znoxx/ARCAdaptor/README.md

ARCAdaptor
==========
https://github.com/znoxx/ARCAdaptor

Arcadaptor stuff - schematic, firmware, libs

For details, check http://adaptor.su
=======
