znoxx/ARCAdaptor/hardware/readme.txt

In EAGLECAD format. No board still, but quite easy to make your own or buy pre-made at http://adapto.rs
