znoxx/ARCAdaptor/projects/ARCAdaptor_USBasp/README.md

This project intended to adapt original USBasp programmer code with ARCAdaptor
Original file from http://www.fischl.de/usbasp/ for preservation
Directory "replacement" contains patched files - to compile - replace original content with them.
Pins of ARCAdaptor used:

X2-13 PB2 - Reset
X2-15 PB3 - MOSI
X1-3 PB4 - MISO
X1-1 PB5 - SCK

Also possible to attach leds to pins
X1-5 PC0 LED1
X1-7 PC1 LED2
Anyway, check pin assignemt according to original USBasp schematics + ARCAdaptor pin assignment - http://adapto.rs/arc/doc/
