znoxx/ARCAdaptor/docs/wikiimages/1-bascom-avr-start.jpg

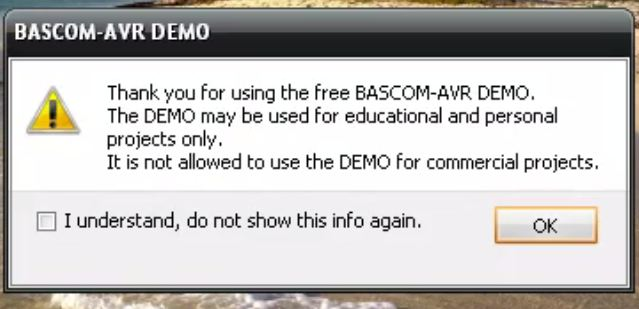
docs/wikiimages/1-bascom-avr-start.jpg
