znoxx/ARCAdaptor/docs/wikiimages/2-bascom-avr-load.jpg

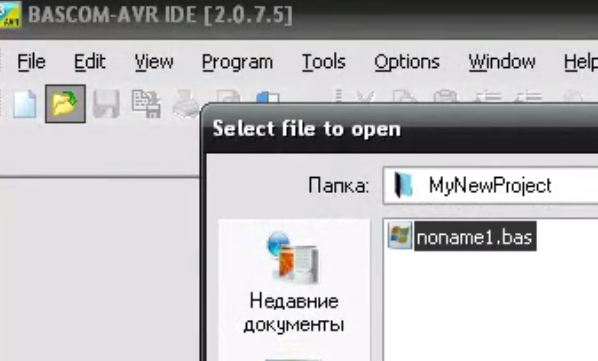
docs/wikiimages/2-bascom-avr-load.jpg
