znoxx/ARCAdaptor/docs/wikiimages/2buttonjoy-diagramm.png

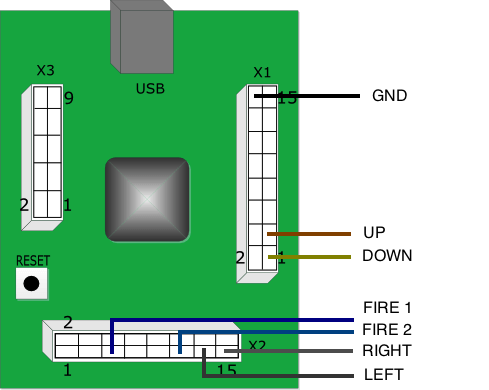
docs/wikiimages/2buttonjoy-diagramm.png
