znoxx/ARCAdaptor/docs/wikiimages/2buttonjoy-photo.jpg

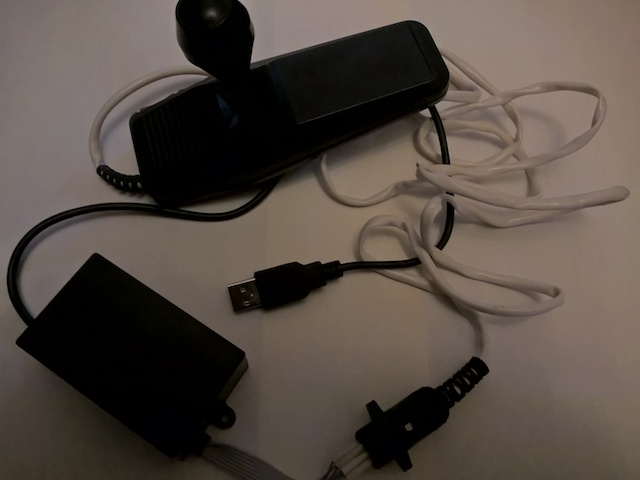
docs/wikiimages/2buttonjoy-photo.jpg
