znoxx/ARCAdaptor/docs/wikiimages/2buttonjoy-screenshot.png

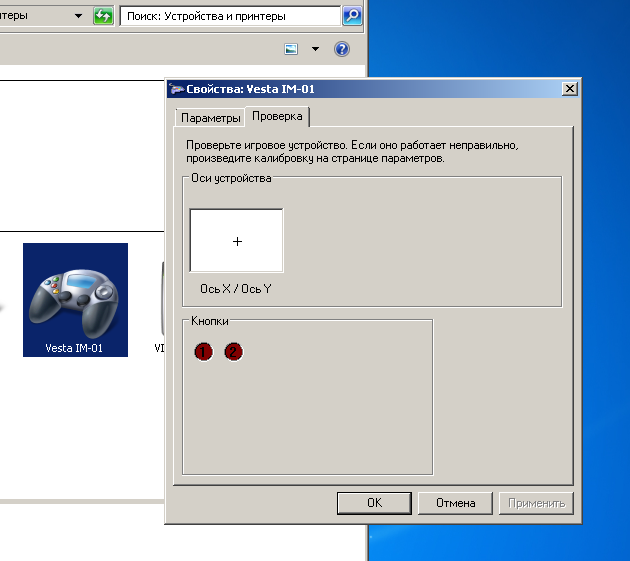
docs/wikiimages/2buttonjoy-screenshot.png
