znoxx/ARCAdaptor/docs/wikiimages/3-loaded-file.jpg

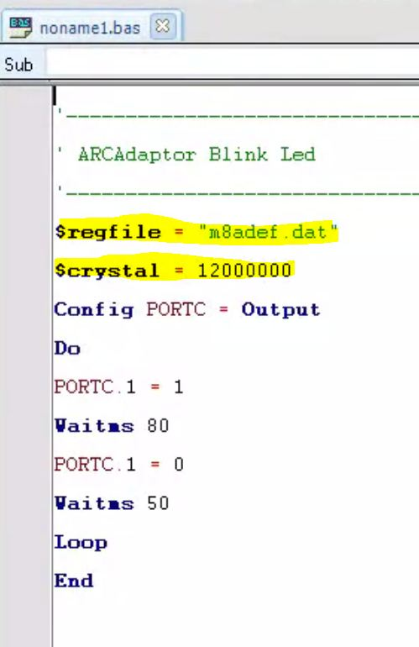
docs/wikiimages/3-loaded-file.jpg
