znoxx/ARCAdaptor/docs/wikiimages/4-chipmenuselect.jpg

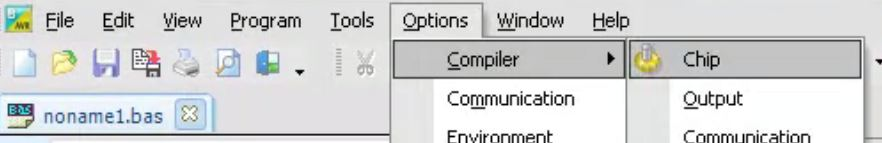
docs/wikiimages/4-chipmenuselect.jpg
