znoxx/ARCAdaptor/docs/wikiimages/5-programmer-options.jpg

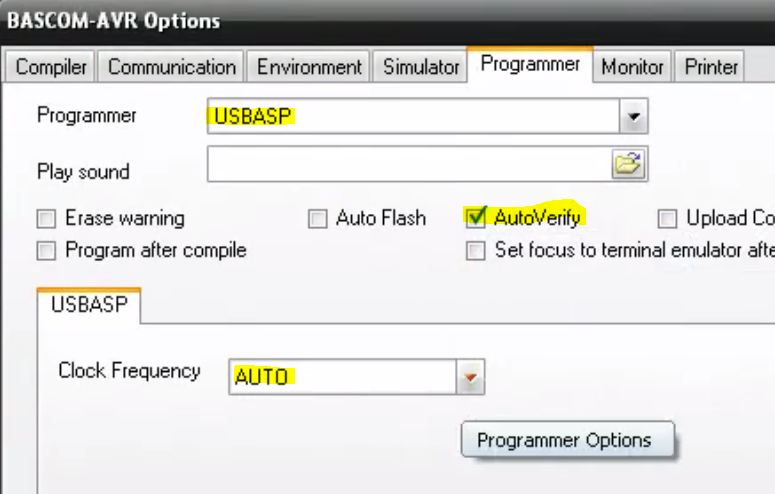
docs/wikiimages/5-programmer-options.jpg
