znoxx/ARCAdaptor/docs/wikiimages/6-atmega8aselection.jpg

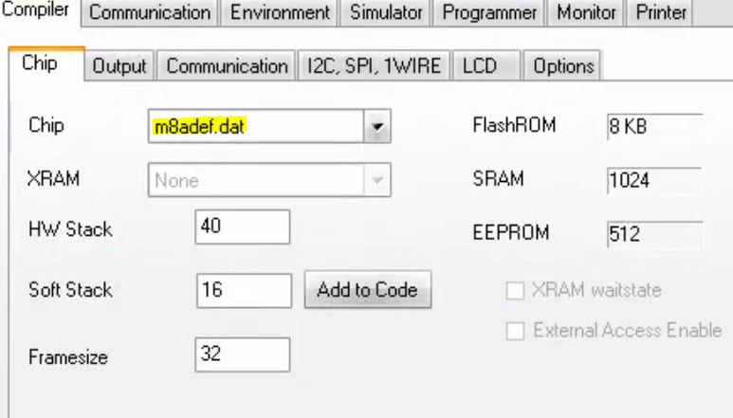
docs/wikiimages/6-atmega8aselection.jpg
