znoxx/ARCAdaptor/docs/wikiimages/7-select-frequency.jpg

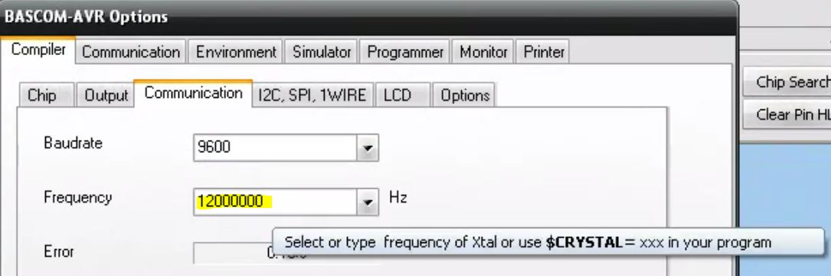
docs/wikiimages/7-select-frequency.jpg
