znoxx/ARCAdaptor/docs/wikiimages/8-add_to_code_optional.jpg

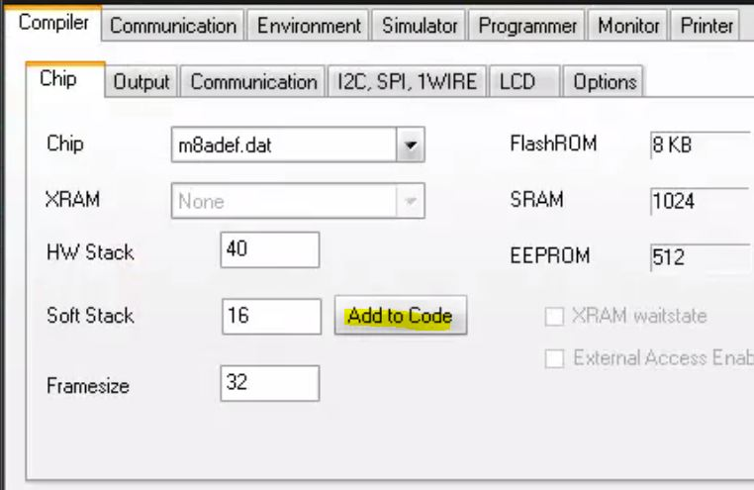
docs/wikiimages/8-add_to_code_optional.jpg
