znoxx/ARCAdaptor/docs/wikiimages/9-compile.jpg

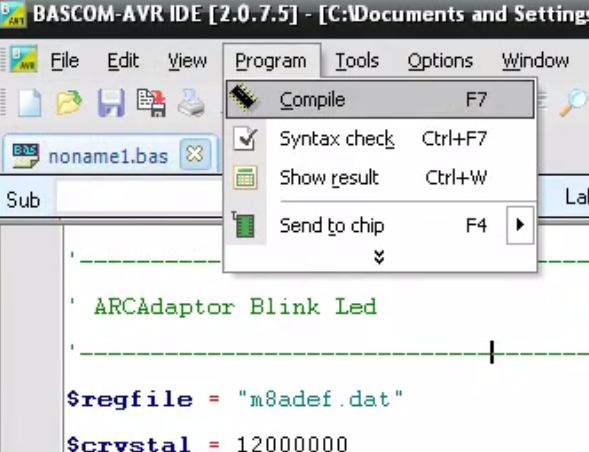
docs/wikiimages/9-compile.jpg
