znoxx/ARCAdaptor/docs/wikiimages/10-devmanager.jpg

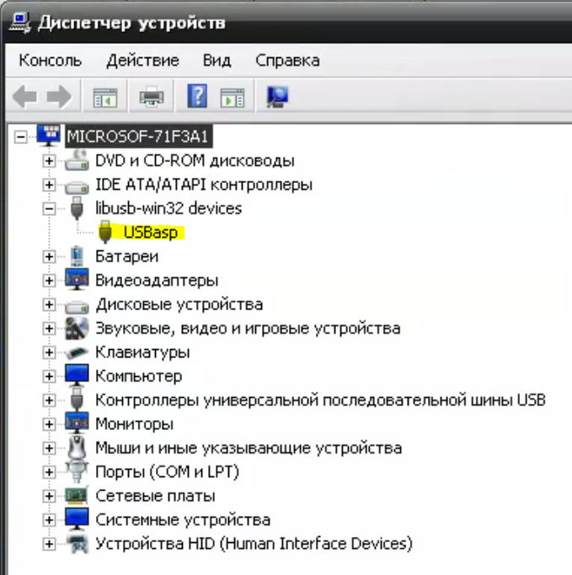
docs/wikiimages/10-devmanager.jpg
