znoxx/ARCAdaptor/docs/wikiimages/12-save_to_chip.jpg

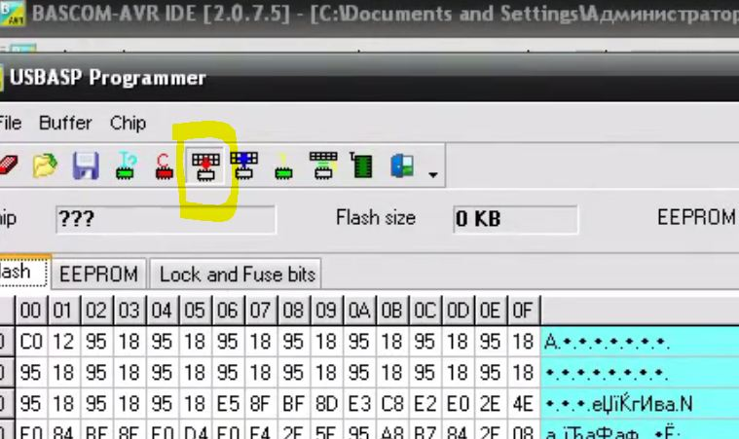
docs/wikiimages/12-save_to_chip.jpg
