znoxx/ARCAdaptor/docs/wikiimages/arcadaptorZX.jpg

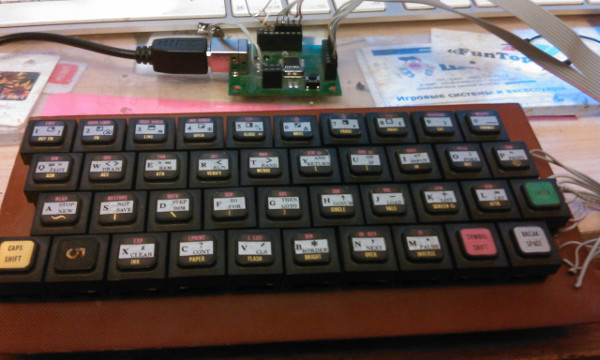
docs/wikiimages/arcadaptorZX.jpg
