znoxx/ARCAdaptor/docs/wikiimages/atx_driver.png

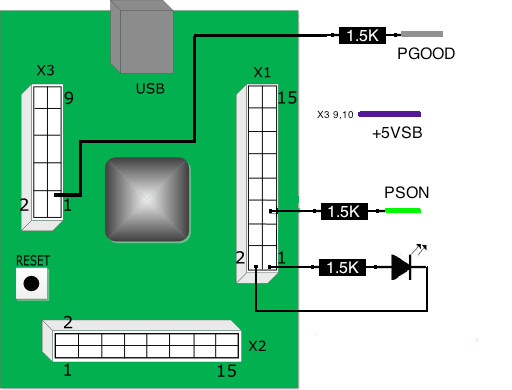
docs/wikiimages/atx_driver.png
