znoxx/ARCAdaptor/docs/wikiimages/beginner73-1.png

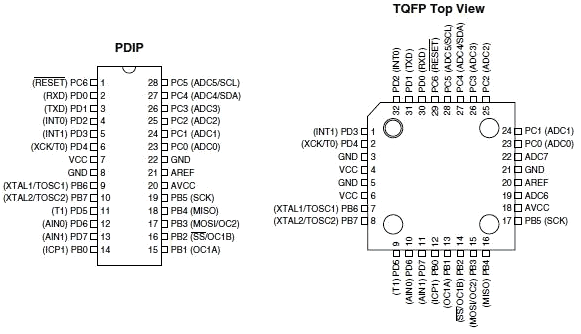
docs/wikiimages/beginner73-1.png
