znoxx/ARCAdaptor/docs/wikiimages/board_diagramm_usbled.png

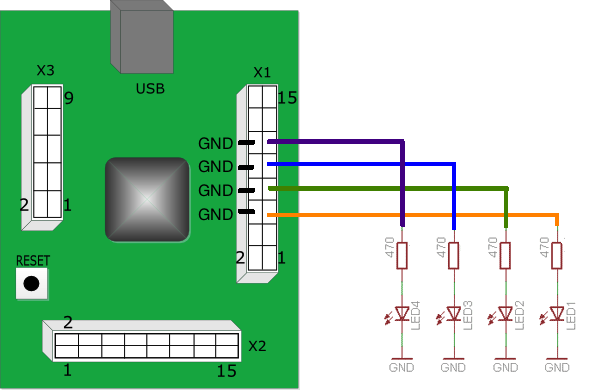
docs/wikiimages/board_diagramm_usbled.png
