znoxx/ARCAdaptor/docs/wikiimages/diagramm-zx.png

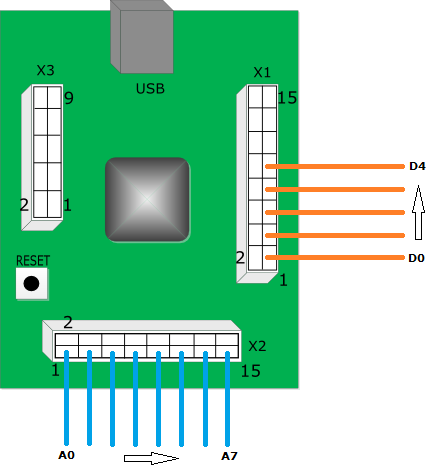
docs/wikiimages/diagramm-zx.png
