znoxx/ARCAdaptor/docs/wikiimages/HIDSerial.jpg

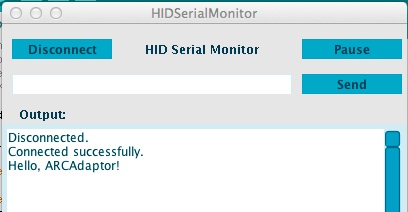
docs/wikiimages/HIDSerial.jpg
