znoxx/ARCAdaptor/docs/wikiimages/i2c.png

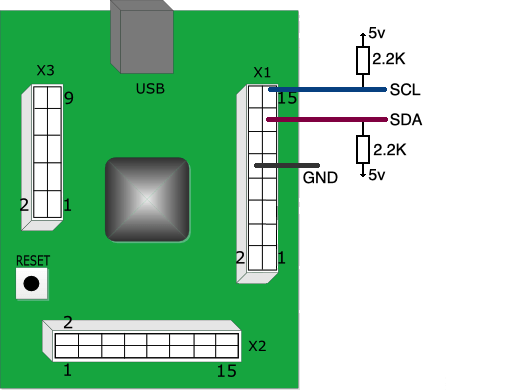
docs/wikiimages/i2c.png
