znoxx/ARCAdaptor/docs/wikiimages/i25_keyb1.png

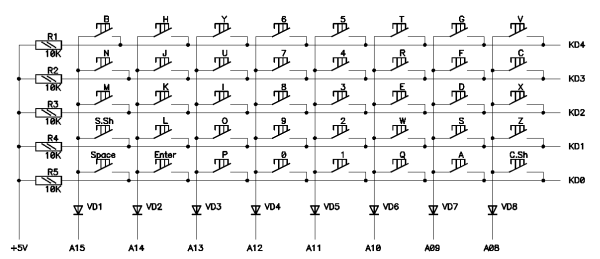
docs/wikiimages/i25_keyb1.png
