znoxx/ARCAdaptor/docs/wikiimages/keylayout.jpg

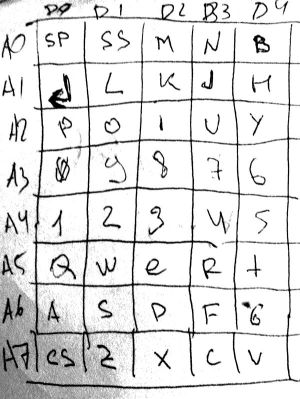
docs/wikiimages/keylayout.jpg
