znoxx/ARCAdaptor/docs/wikiimages/LEDConnection1.png

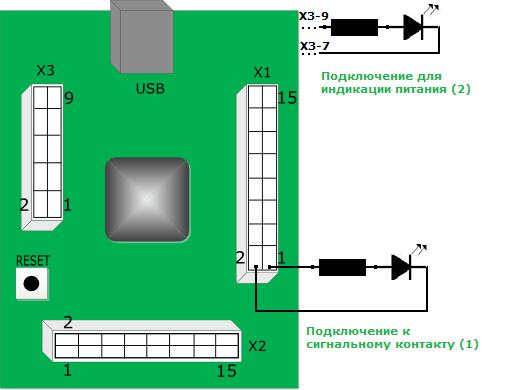
docs/wikiimages/LEDConnection1.png
