znoxx/ARCAdaptor/docs/wikiimages/mainpage.jpg

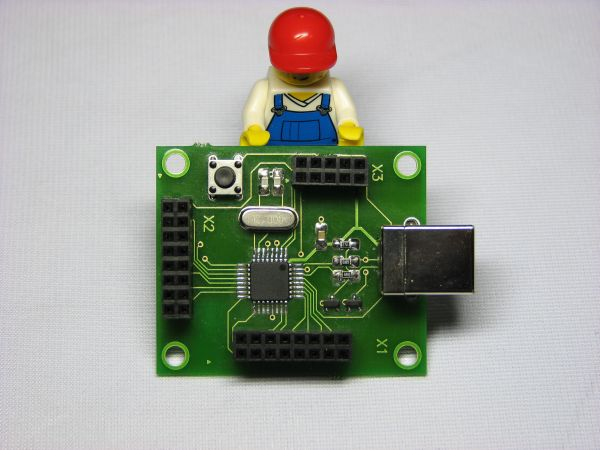
docs/wikiimages/mainpage.jpg
