znoxx/ARCAdaptor/docs/wikiimages/USBasp-photo.jpg

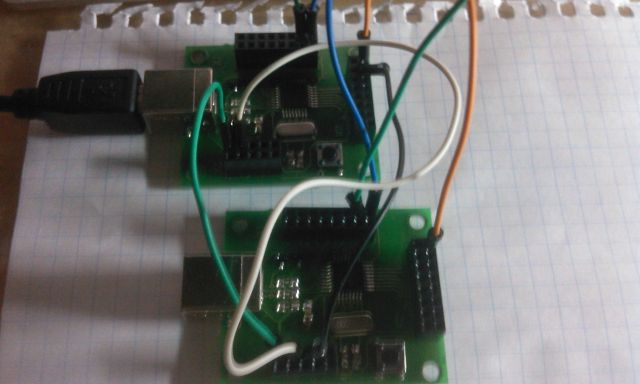
docs/wikiimages/USBasp-photo.jpg
