znoxx/ARCAdaptor/docs/wikiimages/USBasp-screenshot.jpg

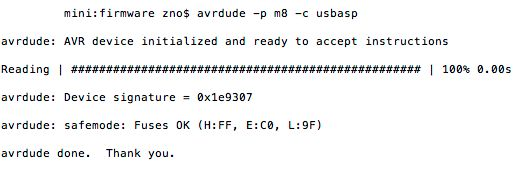
docs/wikiimages/USBasp-screenshot.jpg
