znoxx/ARCAdaptor/docs/wikiimages/USBasp.png

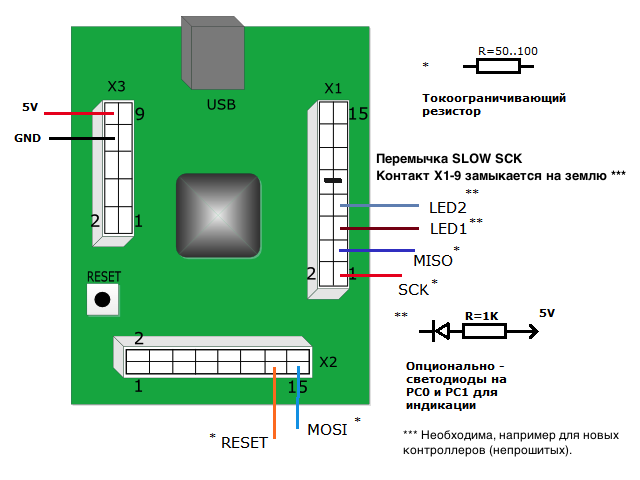
docs/wikiimages/USBasp.png
