znoxx/ARCAdaptor/docs/wikiimages/usbfadertest.png

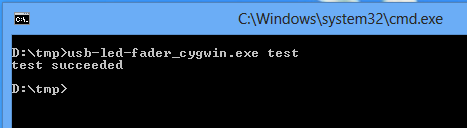
docs/wikiimages/usbfadertest.png
