znoxx/ARCAdaptor/docs/wikiimages/usbpassgen.jpg

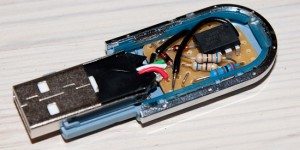
docs/wikiimages/usbpassgen.jpg
