znoxx/ARCAdaptor/hardware/ARCAdaptor.png

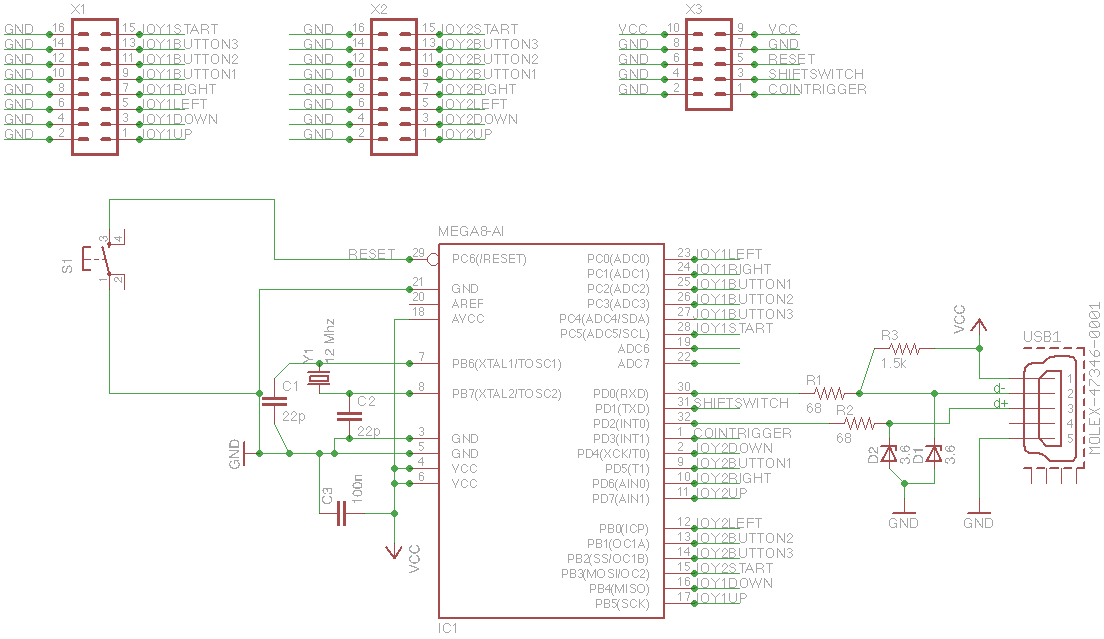
hardware/ARCAdaptor.png
