znoxx/ARCAdaptor/docs/manual/README.md

# User manual for ARCAdaptor project

In Russian. Markdown version not in GFM format - *strict markdown* used.
Pandoc is used for generation of HTML.
* Install [pandoc](http://pandoc.org)
* Run `make index.html` or `make`
* Open index.html in browser
* Don't forget **images** and **styles** folders, if you want to upload HTML
 version somewhere
