znoxx/ARCAdaptor/docs/wikiimages/install-led-01.gif

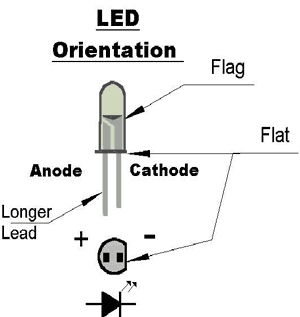
docs/wikiimages/install-led-01.gif
