znoxx/ARCAdaptor/zeroadaptor/zeroAdaptor.pdf

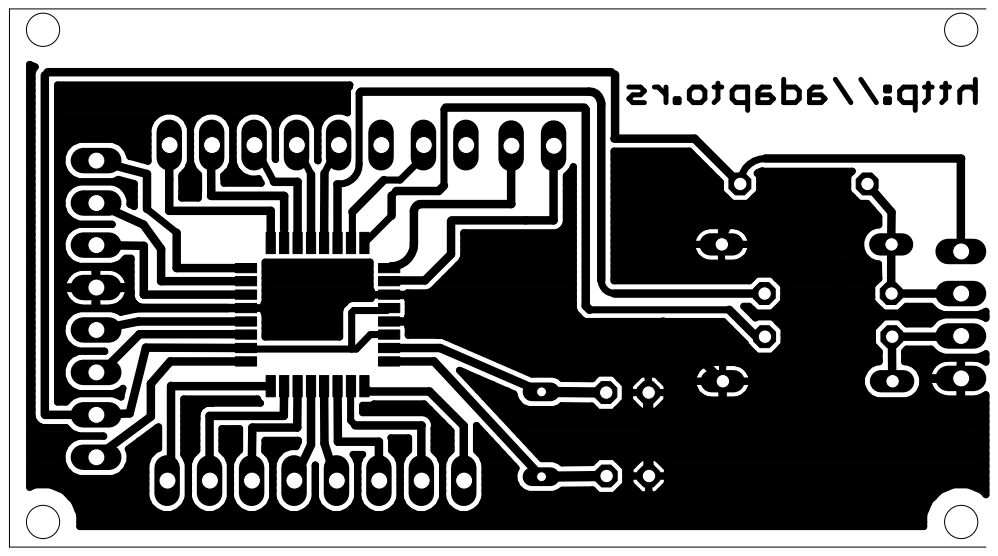
[picture p58: page 1]
