znoxx/ARCAdaptor/zeroadaptor/zeroAdaptor.brd

## EAGLE design zeroadaptor/zeroAdaptor.brd (2016-02-27)

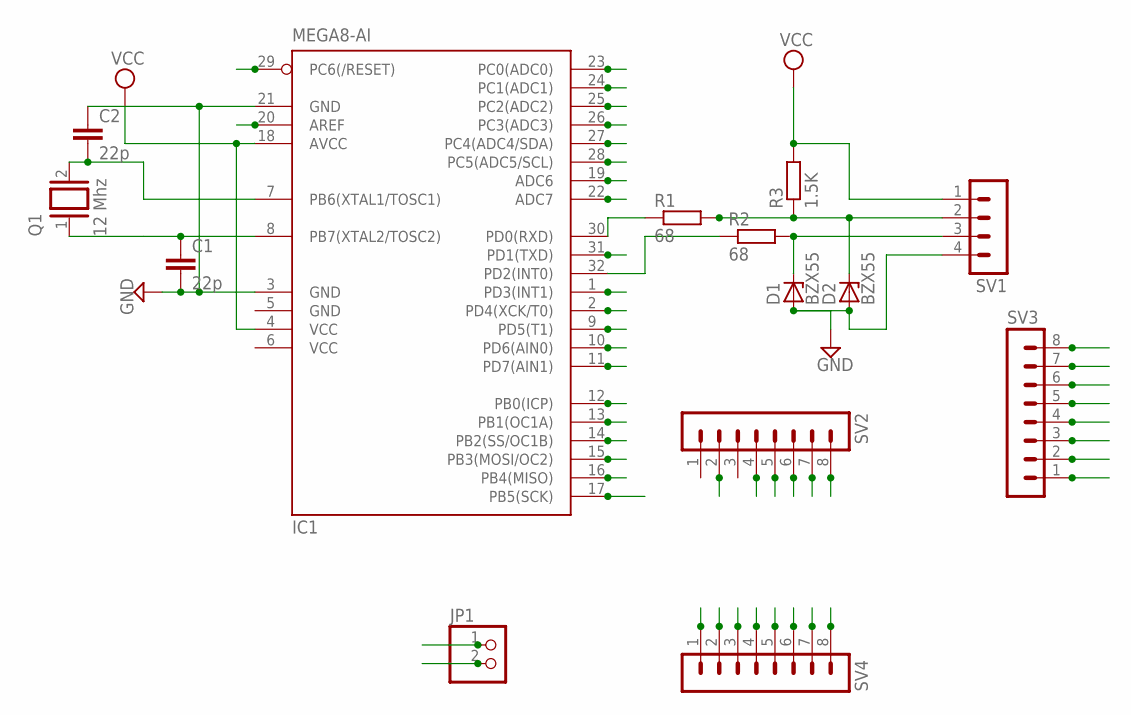
[picture p59: schematic zeroAdaptor.sch]

Parts:
C1, C2: 22p; C025-024X044
D1, D2: BZX55; DO35Z10
IC1: MEGA8-AI; TQFP32-08
JP1: PINHD-1X2; 1X02
Q1: 12 Mhz; QS
R1, R2: 68; 0204/7
R3: 1.5K; 0204/7
SV1: MA04-1
SV2, SV3, SV4: MA08-1

Connections:
ADC6: IC1.19 (ADC6), SV3.3
ADC7: IC1.22 (ADC7), SV3.6
AREF: IC1.20 (AREF), SV3.4
GND: C1.2, C2.1, D1.A, D2.A, IC1.3 (GND), IC1.5 (GND), IC1.21 (GND), SV1.4, SV3.5
unnamed: C2.2, IC1.7 (PB6(XTAL1/TOSC1)), Q1.2
unnamed: C1.1, IC1.8 (PB7(XTAL2/TOSC2)), Q1.1
unnamed: IC1.30 (PD0(RXD)), R1.1
unnamed: IC1.32 (PD2(INT0)), R2.1
unnamed: D1.C, R2.2, SV1.3
unnamed: D2.C, R1.2, R3.1, SV1.2
PB0: IC1.12 (PB0(ICP)), SV4.4
PB1: IC1.13 (PB1(OC1A)), SV4.5
PB2: IC1.14 (PB2(SS/OC1B)), SV4.6
PB3: IC1.15 (PB3(MOSI/OC2)), SV4.7
PB4: IC1.16 (PB4(MISO)), SV4.8
PB5: IC1.17 (PB5(SCK)), SV3.1
PC0: IC1.23 (PC0(ADC0)), SV3.7
PC1: IC1.24 (PC1(ADC1)), SV3.8
PC2: IC1.25 (PC2(ADC2)), SV2.8
PC3: IC1.26 (PC3(ADC3)), SV2.7
PC4: IC1.27 (PC4(ADC4/SDA)), SV2.6
PC5: IC1.28 (PC5(ADC5/SCL)), SV2.5
PC6: IC1.29 (PC6(/RESET)), SV2.4
PD1: IC1.31 (PD1(TXD)), SV2.2
PD3: IC1.1 (PD3(INT1)), JP1.1
PD4: IC1.2 (PD4(XCK/T0)), JP1.2
PD5: IC1.9 (PD5(T1)), SV4.1
PD6: IC1.10 (PD6(AIN0)), SV4.2
PD7: IC1.11 (PD7(AIN1)), SV4.3
VCC: IC1.4 (VCC), IC1.6 (VCC), IC1.18 (AVCC), R3.2, SV1.1, SV3.2

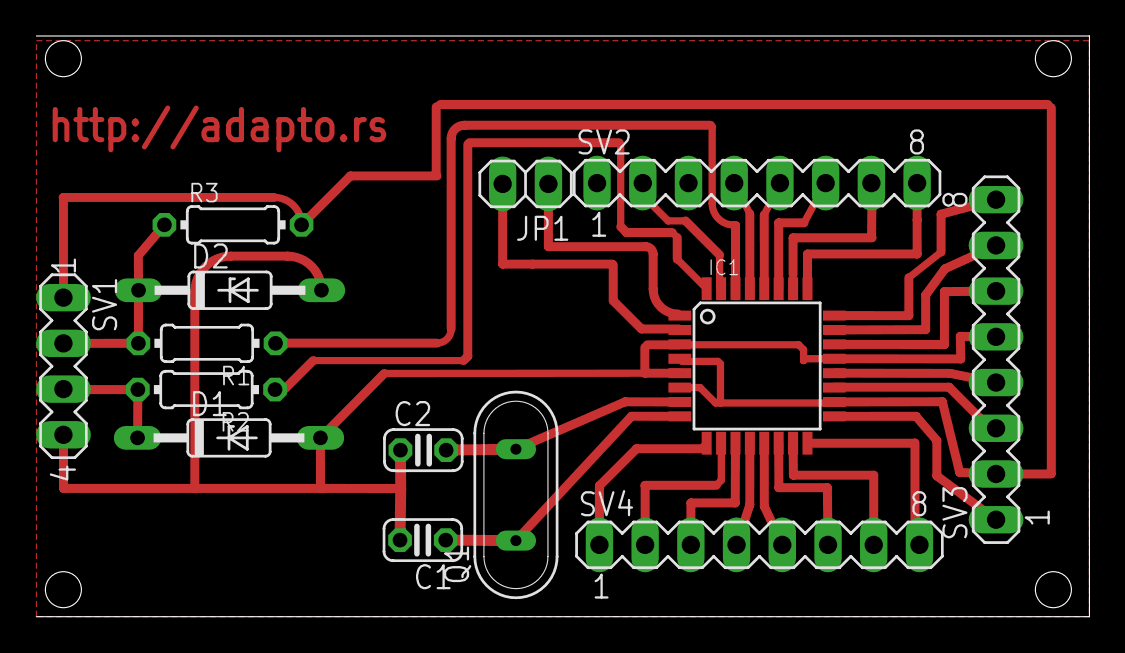
[picture p60: board zeroAdaptor.brd from above]

Board: 2 copper layers, 58.5 x 32.3 mm, 14 parts (0 on the bottom side), 30 nets.
