znoxx/ARCAdaptor/(commit log)

2013-11-30 Added schematic
    Initial version of ARCAdaptor schematic
    [ARCAdaptor.sch]
2013-11-30 ARCAdaptor schematics
    ARCAdaptor schematics, initial verison
2013-11-30 Firmware, bootloader, arduino settings and some projects
    Added source code, bootloader, arduino settins and some projects to
    illustrate
2013-11-30 Added readme.txt for schematics, main readme updated
2013-12-17 Stuff added, including V-USB arduino libs
    Added Arduino libs, Windows flash scripts, and win version of AVRDude.
2014-02-03 V-USB Keyboard library mod and sketch for Arduino
    Added new method to V-USB library : sendBuffer
    Added sketch to control ZX-Spectrum original 40 key keyboard
2014-02-03 Added initial ARCAdaptor arduino library
    ARCAdaptor pins for Arduino mapping
    just include “ARCAdaptor.h” to your sketch and start using ARCAdaptor
    pins in natural way
2014-02-10 Added patch to support HIDSerial component
    HIDSerial allows to debug via USB HID device, instead of serial.
    Original code:
    https://rayshobby.net/?p=7363
    https://github.com/rayshobby/hid-serial
2015-04-03 Updated settings for Arduino 1.5.x
    Added arduino 1.5.x settings, previous moved to pre-1.5
2016-02-27 Added DYI version
    ZeroAdaptor - minimal version for PCB etching@home
    [zeroAdaptor.brd, zeroAdaptor.sch]
2017-10-13 Added ATX driver example pic
2020-05-11 Adopted original I2C-Tiny-USB from Till Harbaum
